harry878710/Automatic_Mobile_Boat_CapstoneTopics/工科專論_期末報告_第九組.pdf

## 工科專論<第九組>期末報告

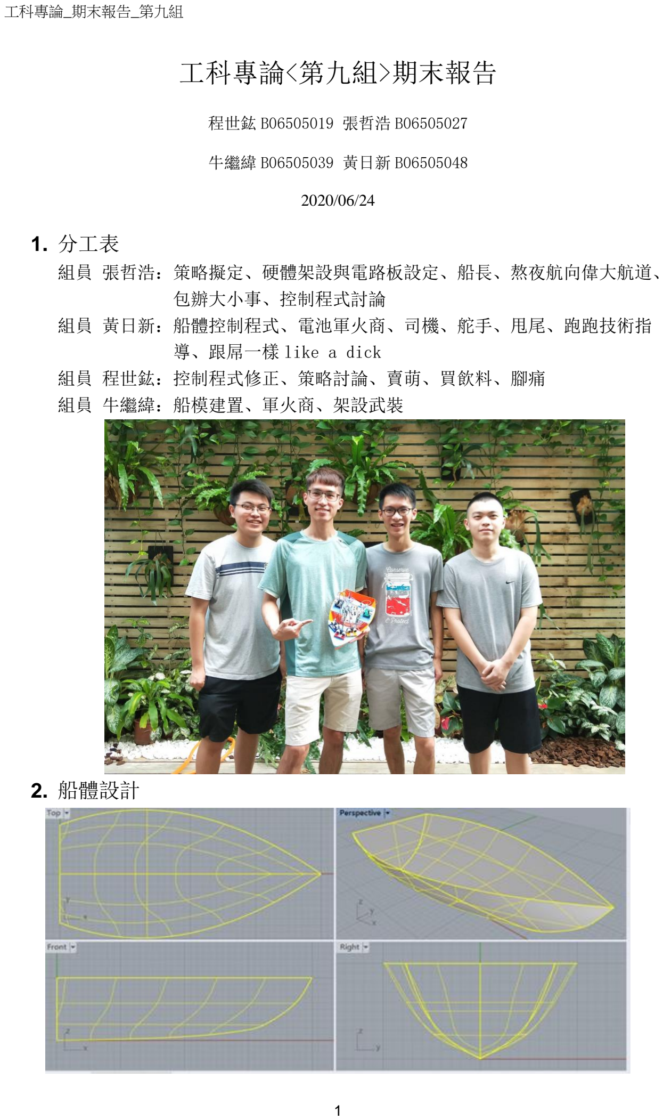
[picture p1: page 1]

工科專論_期末報告_第九組

程世鈜 B06505019 張哲浩 B06505027

牛繼緯 B06505039 黃日新 B06505048

2020/06/24

### 1. 分工表

組員 張哲浩：策略擬定、硬體架設與電路板設定、船長、熬夜航向偉大航道、 包辦大小事、控制程式討論
組員 黃日新：船體控制程式、電池軍火商、司機、舵手、甩尾、跑跑技術指 導、跟屌一樣 like a dick
組員 程世鈜：控制程式修正、策略討論、賣萌、買飲料、腳痛
組員 牛繼緯：船模建置、軍火商、架設武裝

### 2. 船體設計

考慮到長度限制、吃水、賽道寬度和旋轉半徑，將船長設為 40cm，船寬設為 20cm，船高 10cm，盡量在符合規定的範圍內取得吃水深度與旋轉半徑兩者間的平衡， 讓船不至於太長而造成轉彎不易或因為迴轉半徑過大而增加碰撞，也不會因為太短而 需要增加高度來達到目標的排水量；船寬則因為原本賽道迴轉區寬度為 30cm，略寬的 船體可以讓超音波感測器更快感測到牆壁而避免碰撞。
船體設計為了避免翻船或晃動過多導致進水，整體以穩度為優先考量，因此使

用倒三角形的船型來設計來增加 GM 值，最後的效果也不錯(1.42 cm)，同時倒三角形

也能有效地增加預備浮力；船底的部分收成直角，可以比圓弧型的船底增加更多吃水

面積，船的高度也能控制在一定範圍內，使重心不會偏高；船身的部分盡量把曲率拉

得連續，讓整體形狀更加流線以降低水的阻力；船尾選擇切齊而不做尖尾是為了能讓

船體在有限的長度內增加吃水面積，讓水線不要太高，同時也能增加船體的實際長

度，但在這裡因為速度較低所以影響應該不大。
螺槳裝在船的正後方以發揮最大動力，高度約在船底到水線的中間，使兩者不 會因為距離太近而互相影響，也足夠提供轉彎所需的較大力矩。馬達因為考慮到軸的 長度設置在船體的偏前方處，同時也因船體後方較深、前方較淺，因此將主電路板和 電池裝設在後方，使整體重心能與空船時保持一致。
4. 放入你船體的實際圖片

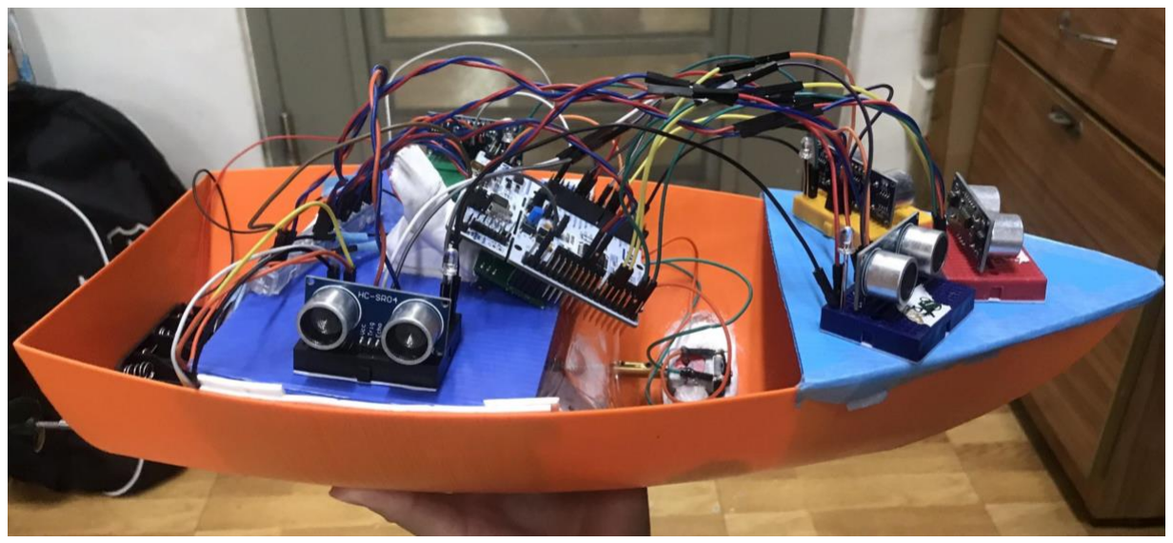
[picture p2: figure]

fg. 跟屌一樣號

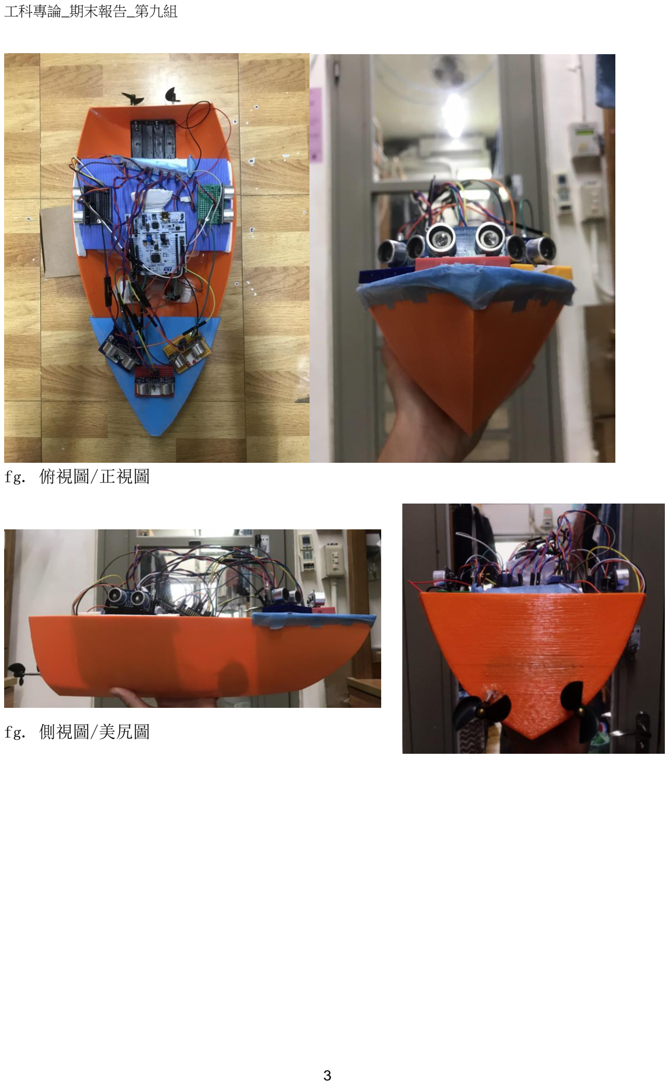
[picture p3: page 3]

fg. 俯視圖/正視圖

fg. 側視圖/美尻圖

### 3. 電路設計

控制硬體(stm32)設置：

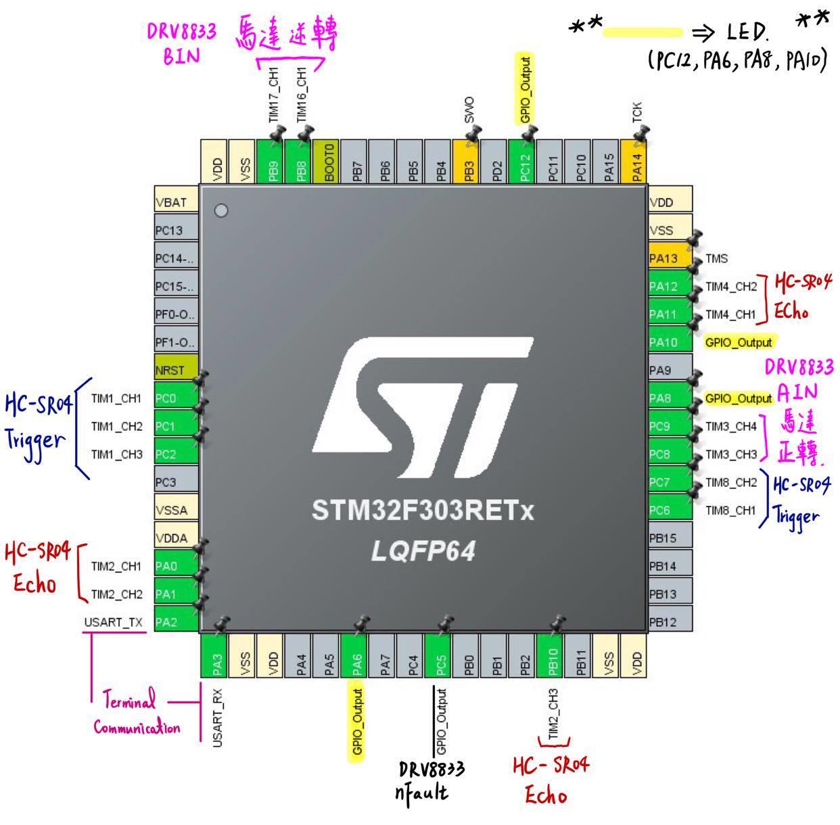
[picture p4: figure]

TIM/GPIO 的使用：

TIM 總共使用 7 個

TIM1 & TIM8 負責超音波 Trigger，TIM2 & TIM4 負責超音波 Echo，TIM3 & TIM16 & TIM17 負責控制馬達。

GPIO Output 總共使用 5 個

PC5 控制馬達晶片的開啟。
PA10/PA6/PA8/PC12 分別控制 左前/右前/左邊/右邊 的 LED 燈。

USART：
PA2/PA3 分別控制 USART_TX & USART_RX 與電腦終端機做溝通，確認超音波測距狀 況。

馬達驅動：

我們將馬達的正負極接到 4 個 Channel 分別設為 PWM Generation，將 counter period 設為 100，如此一來可以將轉速分級成百分比制，控制車輪的正逆轉。

分別開啟 TIM3_CH3 & TIM3_CH4 設為控制馬達正轉，TIM16_CH1 & TIM17_CH1 控 制逆轉。

超音波測距：

超聲波我們總共使用五組，設置三組測量前方（正前、左前 40 度、右前 40 度），兩組後方測量左右方與船身平行的牆面距離。

<Trigger>

TIM 配置：左前方 TIM1_CH1 / 前方 TIM1_CH2 / 右前方 TIM1_CH3 / 左後方 TIM8_CH1 / 右後方 TIM8_CH2。

超音波的 Trigger 我們統一將 TIM 的 channel 設為 PWM Generation，因為 TIM 的頻率是 8MHz，所以 Prescaler 我們設為 79，這樣一來一個 tick 所需的時間是 10us，counter period 設為 6999。透過以上設定，就可以透過 PWM 自動且規律地發出 有效訊號：每 70ms 中有 10us 高電位，進而發出訊號。

為了避免干擾，我們按照 左前、正前、右前、左後、右後 感測器的順序，依 序開啟 trigger 發波進行測距，測量完畢就關閉 PWM 換開啟下一個感測器的 PWM 發送 訊號測距。

<Echo>

TIM 配置：左前方 TIM2_CH1 / 前方 TIM2_CH2 / 右前方 TIM2_CH3 / 左後方 TIM4_CH1 / 右後方 TIM4_CH2。

超音波的 Echo 我們將 TIM 的 channel 設定為 input capture direct mode，將 counter period 設為最大，polarity selection 設為 Both Edges，如此一來便可以 抓到從高低電位間轉換的訊號。在 rising edge 將 counter 歸零，falling edge 記 數，記錄 echo 在高電位的總記數，將記數轉換為時間，再計算成距離。

TIM 頻率皆設為 8MHz，prescaler 設為 7，每 1us 記數一次，聲速每 29us 移動 1cm (1cm/(340m*10^2) = 29us)。所以超音波來回距離等於(總記數 cnt*10^-6)/(29*10^-6)，我們所要求的單一趟距離為：cnt/29/2。

控制演算法：

首先定義各個狀態（state），用來代表船不同的行進狀況，各狀態間的轉變條 件會在後面說明。

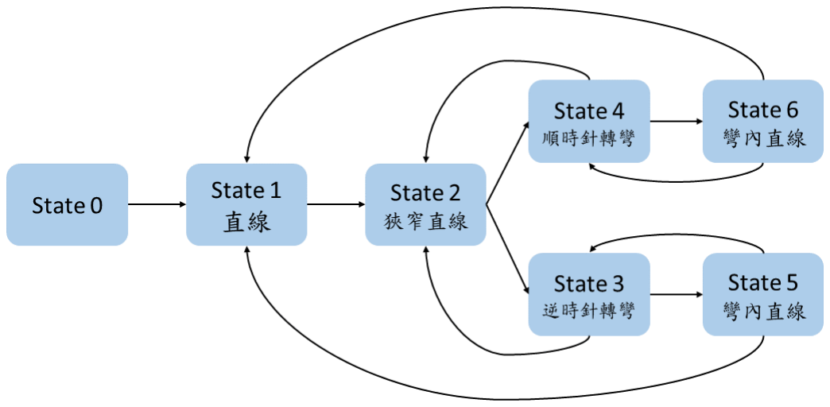
[picture p5: figure]

程式會記錄下感測器最近五次測得的距離，利用上述距離，以及目前的狀態， 判斷船所在位置、姿態和即將面臨的障礙物，透過切換狀態或改變馬達轉速，做出相 對應的動作，以閃避障礙物並通過賽道。不論在任何狀態下，程式都會先判斷船的前 方是否離障礙物太近，若是則會控制馬達逆轉使船後退。

各狀態判斷演算法：

state 0：此為初始狀態，船預設會快速前進。

- 若船有向前移動（前方測距連續兩次降低），即會進入 state 1。

state 1：船預設會中速前進。

- 若偵測到船進入狹窄區（左後方及右後方測距皆小於 30 cm），即會進入 state 2。

state 2：船預設會中速前進。

- 若船有向左右偏移（利用左後方或右後方測距的差值，以及其測距之變化）， 程式會控制馬達轉速修正方向，使船回到賽道中央。
- 若偵測到前方有障礙物（前方測距小 80 cm 且連續下降小於 10 cm 三次），程 式會根據後方超音波測距，判斷船的左右位置，決定要進入 state 3 或 state 4。

state 3：程式會根據前方三個感測器的測距大小，並透過左後方感測器的測距輔助，

定出船身位於彎內的姿態與位置。

- 若判斷船在彎道內側（前方及右前方測距皆過小），則會控制馬達進行左轉。
- 若判斷船在彎道外側（前方測距尚有空間），包含剛從直線區進入或是已經可 以從迴轉區離開，則會控制馬達進行右轉。
- 若前方尚有空間（前方測距或左前方測距大於 70 cm），則會進入 state 5。
- 若前方淨空（前方測距連續三次大於 100 cm），則會回到 state 2。

state 4：此狀態與 state 3 相似，僅將左右側距和左右轉相反。

- 若判斷船在彎道內側（前方及右前方測距皆過小），則會控制馬達進行右轉。
- 若判斷船在彎道外側（前方測距尚有空間），包含剛從直線區進入或是已經可 以從迴轉區離開，則會控制馬達進行左轉。
- 若前方尚有空間（前方測距或右前方測距大於 70 cm），則會進入 state 6。
- 若前方淨空（前方測距連續三次大於 100 cm），則會回到 state 2。

state 5：船預設會慢速前進。

- 若船有向左右偏移（利用右後方測距之變化），程式會控制馬達轉速修正方 向。

- 若偵測到前方有障礙物（前方測距小於 45 cm），則會回到 state 3 繼續左 轉。
- 若前方淨空（前方測距連續三次大於 100 cm），則會回到 state 1。

state 6：此狀態與 state 5 相似，僅將左右側距和左右轉相反。

- 若船有向左右偏移（利用左後方測距之變化），程式會控制馬達轉速修正方 向。
- 若偵測到前方有障礙物（前方測距小於 45 cm），則會回到 state 4 繼續右 轉。
- 若前方淨空（前方測距連續三次大於 100 cm），則會回到 state 1。

各狀態代碼與燈號表：

※燈號代碼：暗燈(0)、慢閃(1)、快閃(2)、亮燈(3)。燈號順序為「左前、右前、左 側、右側」

※燈號表詳見 <4.額外設計>

## 控制程式碼

//全域變數

//「dis_F、dis_rF、dis_lF、dis_rR、dis_lR」分別代表「前方、右前方、左前方、右

後方、左後方」超聲波目前的測距

//「F、rF、lF、rR、lR」代表過去五次的測距

//「LED_rF、LED_lF、LED_right、LED_left」分別代表「右前方、左前方、右側、左

側」LED 的燈號代碼

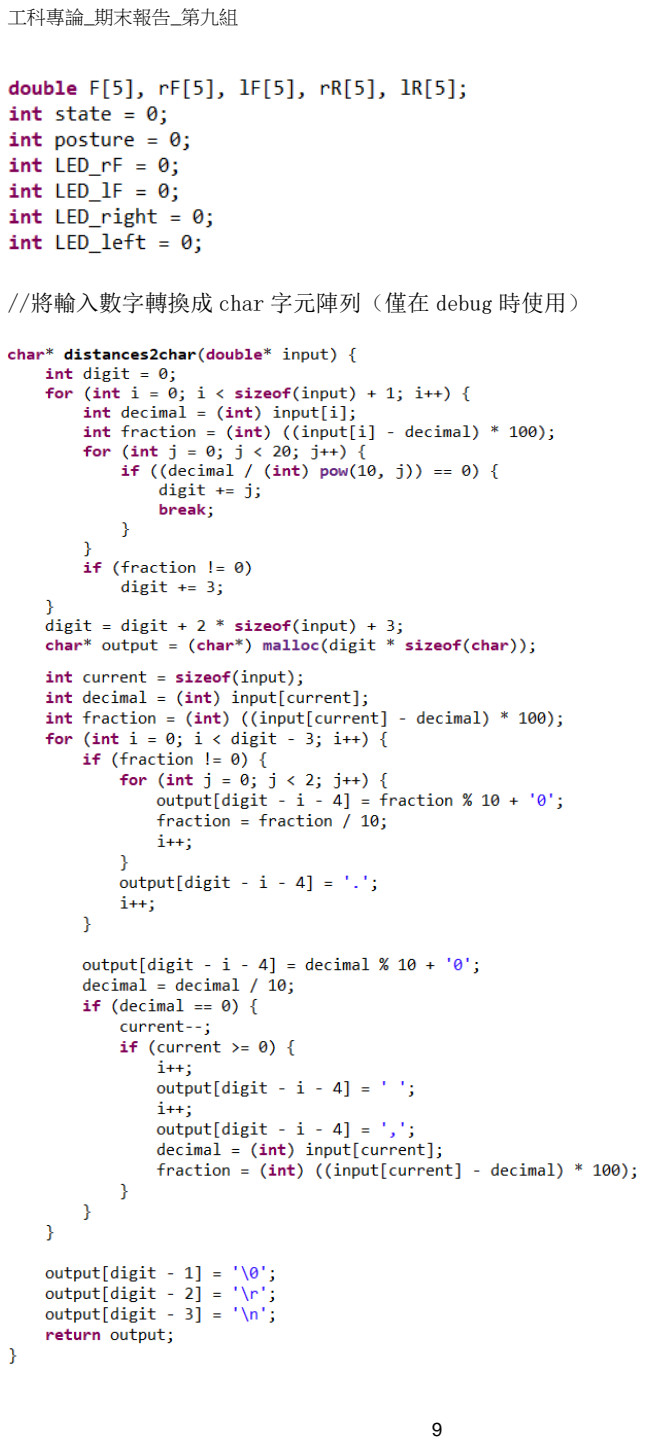
[picture p6: page 9]

//將輸入數字轉換成 char 字元陣列（僅在 debug 時使用）

//將資料回傳至 terminal 並 print 出（僅在 debug 時使用）

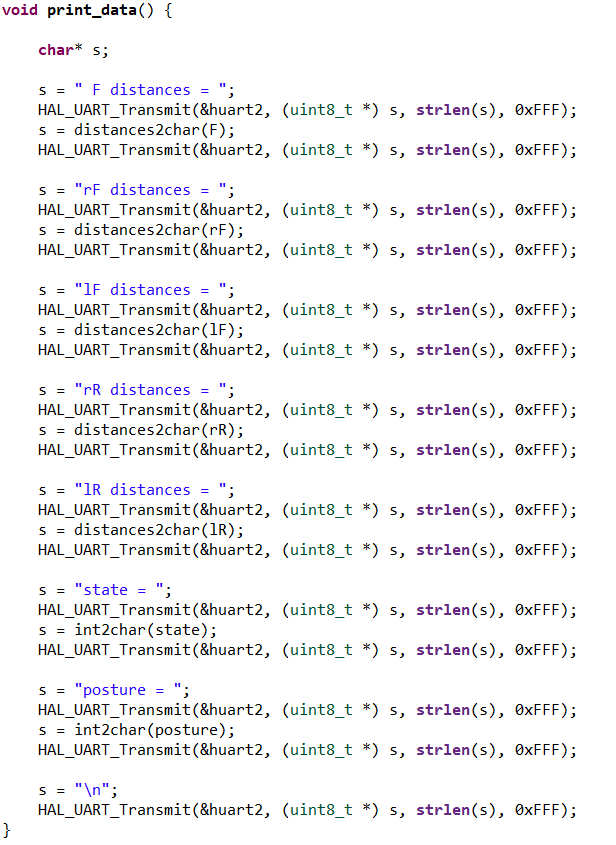
[picture p7: figure]

//超音波的 Echo 測距分別回傳至全域變數 dis_lF, dis_F, dis_rF, dis_lR, dis_rR

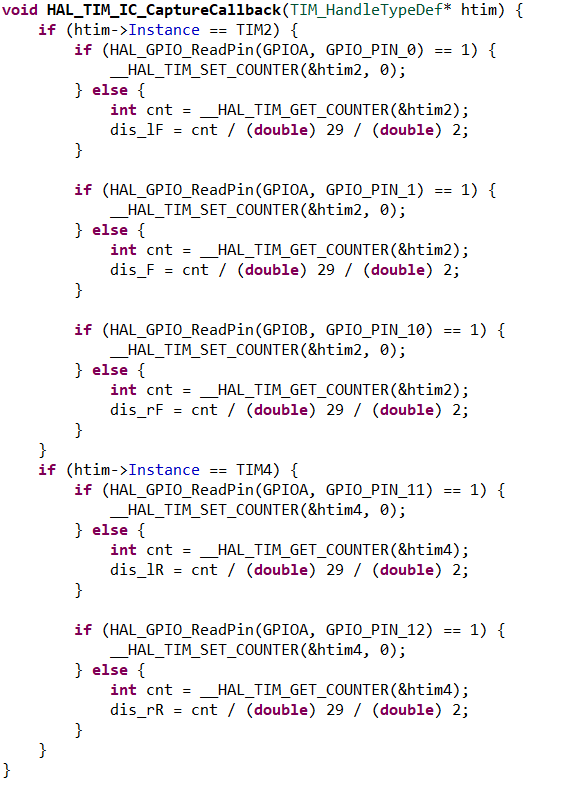
[picture p8: figure]

//進階控制函式，針對不同賽道環境做變化，判斷船的位置與姿態

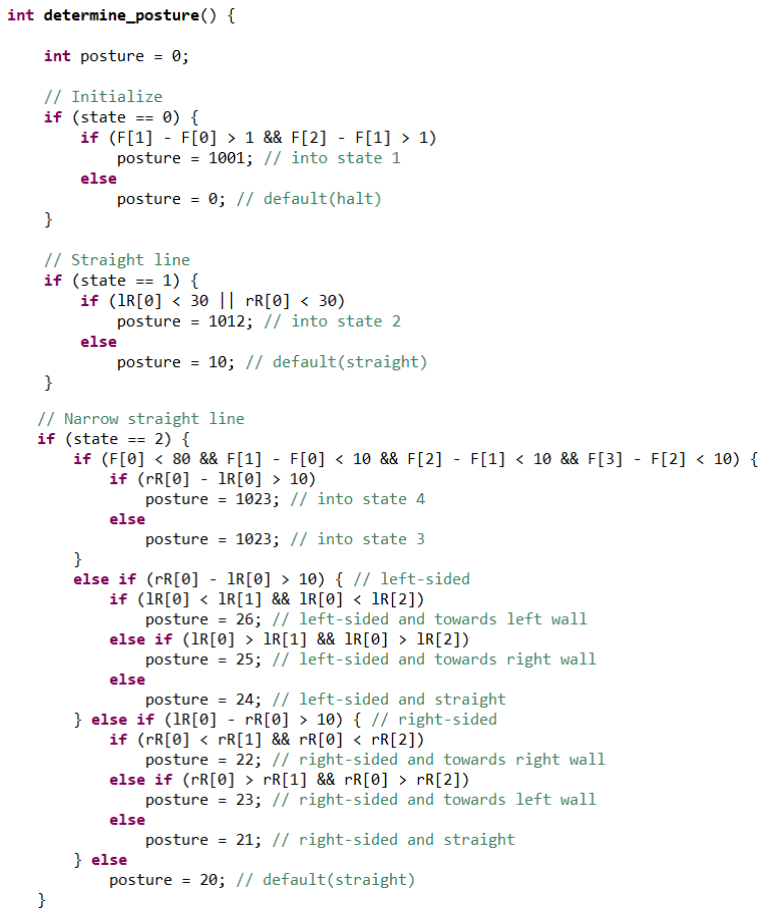
[picture p9: figure]

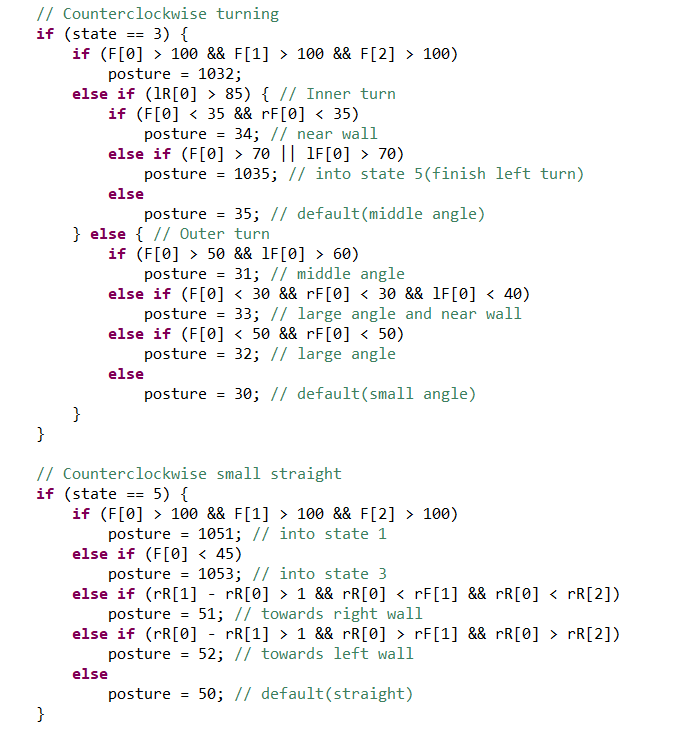
[picture p10: figure]

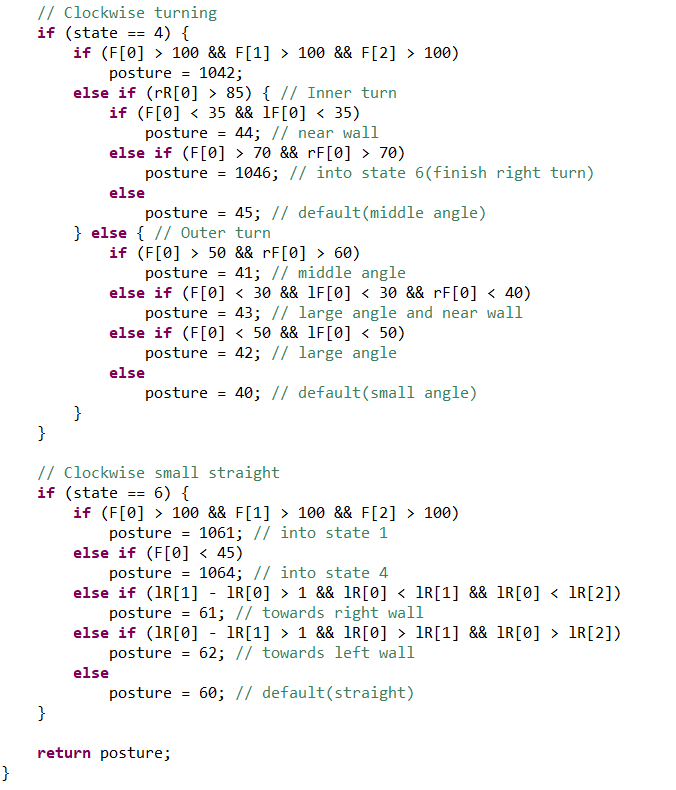
[picture p11: figure]

//由狀態決定馬達的轉速以及 LED 燈的燈號

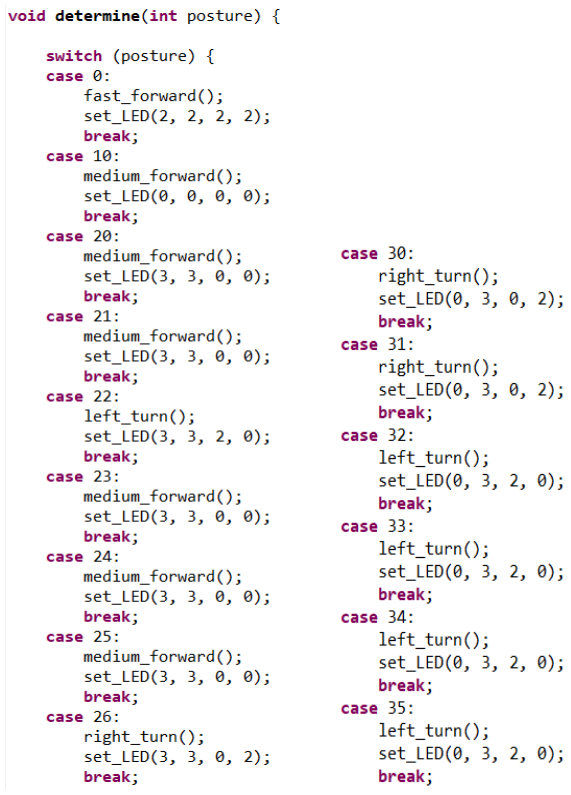
[picture p12: figure]

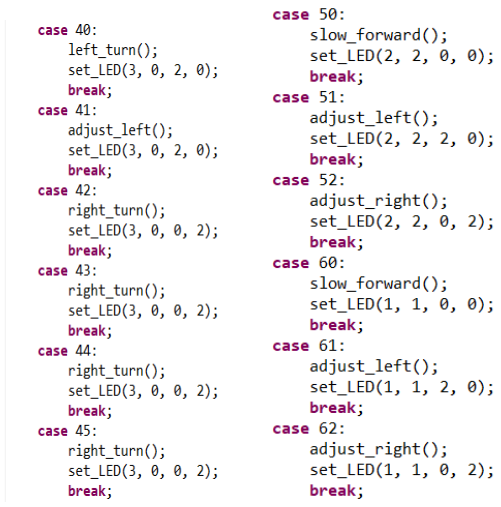
[picture p13: figure]

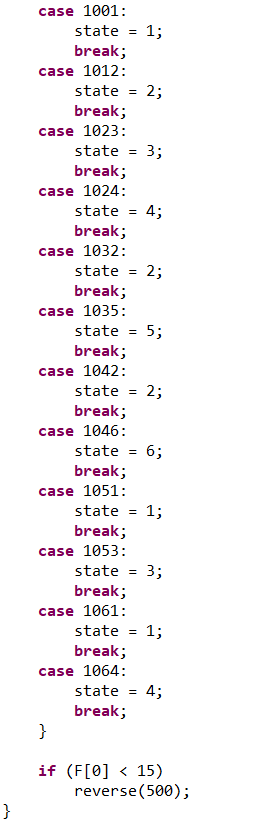
[picture p14: figure]

//各種馬達轉換函式

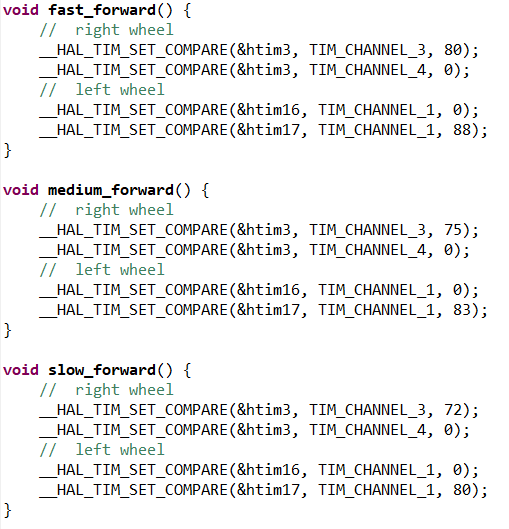
[picture p15: figure]

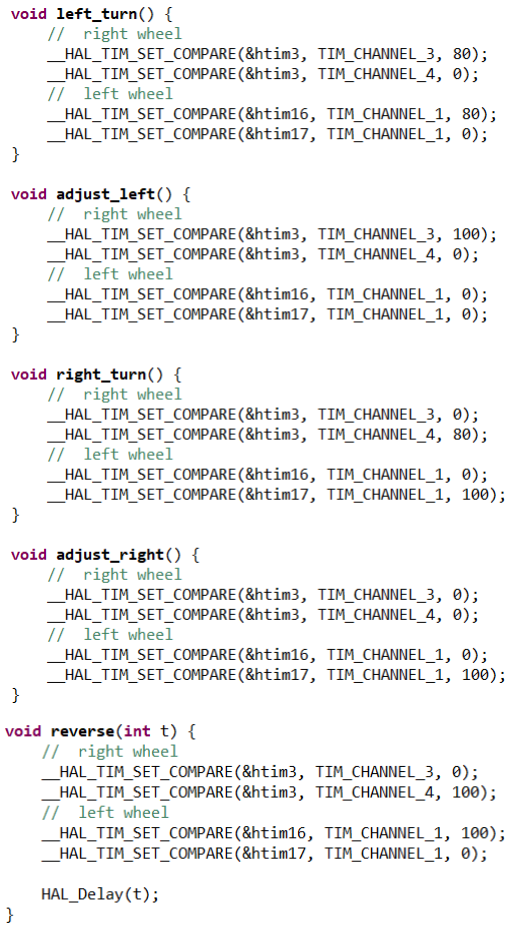
[picture p16: figure]

//LED 燈控制函式

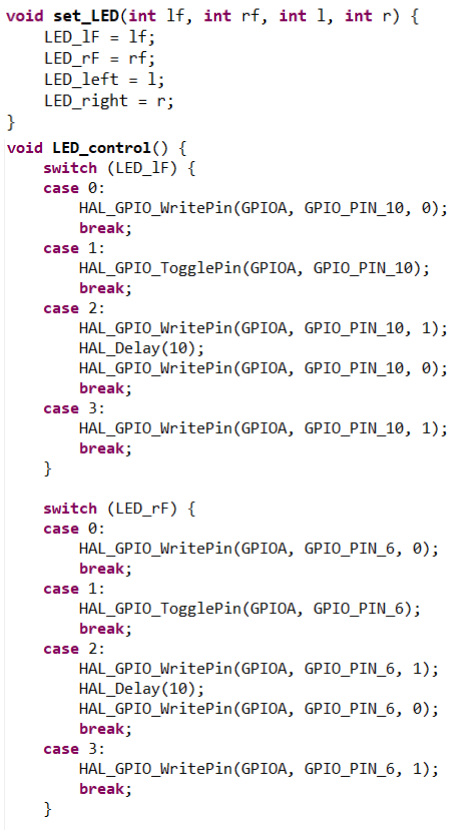
[picture p17: figure]

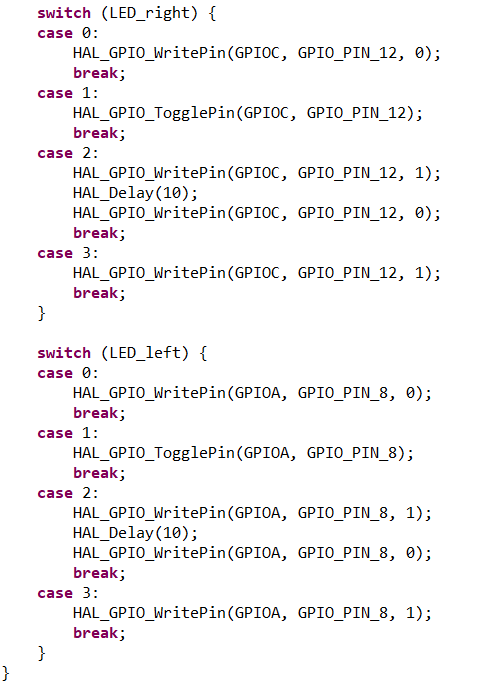
[picture p18: figure]

//以下為 main 函式內的程式碼

//初始化

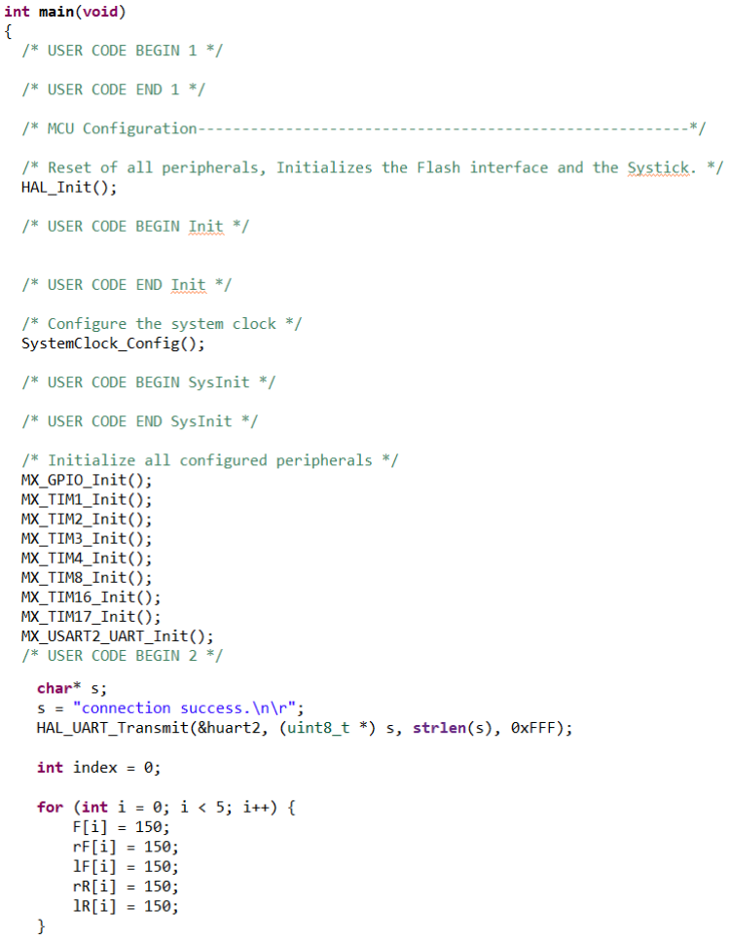
[picture p19: figure]

//開啟馬達 PWM，以及開啟 Echo 腳位 Timer 的 input capture

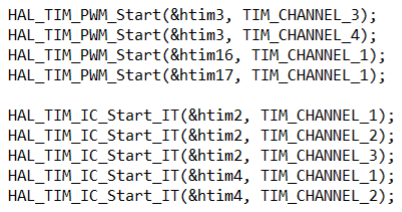
[picture p20: figure]

//程式會記錄下感測器最近五次測得的距離，更新的距離會遞補上去

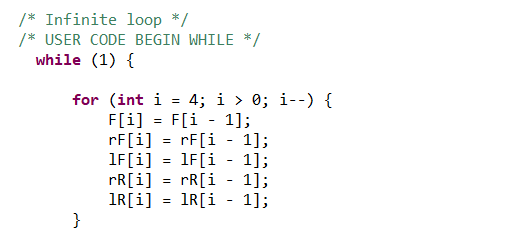
[picture p21: figure]

//超音波 trigger 的 PWM 分別開啟關閉

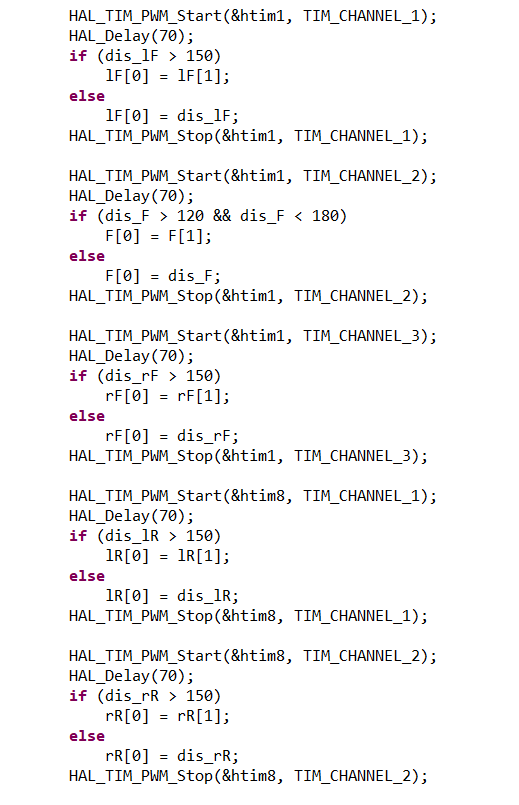
[picture p22: figure]

//執行判斷函式

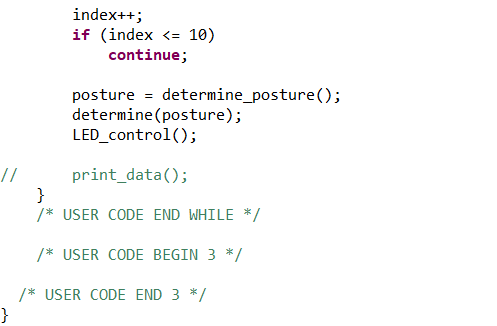
[picture p23: figure]

### 4. 額外設計

由於我們的控制設計使用狀態切換會有不同的控制效果，所以需要確認 船處在哪個狀態，故配置狀態燈以做分析判斷。

前後方左右處各兩顆 LED 燈，總共 4 顆燈製作信號。 燈的狀態有四種：暗燈(0)、慢閃(1)、快閃(2)、亮燈(3)。藉此開發出 以下燈號表（共 2 頁），並確保每位船員熟稔此份燈號表。

電路配置：
設置控制燈泡的腳位為 GPIO Output，分別將 PA10/PA6/PA8/PC12 的腳 位控制左前/右前/左邊/右邊的 LED 燈。

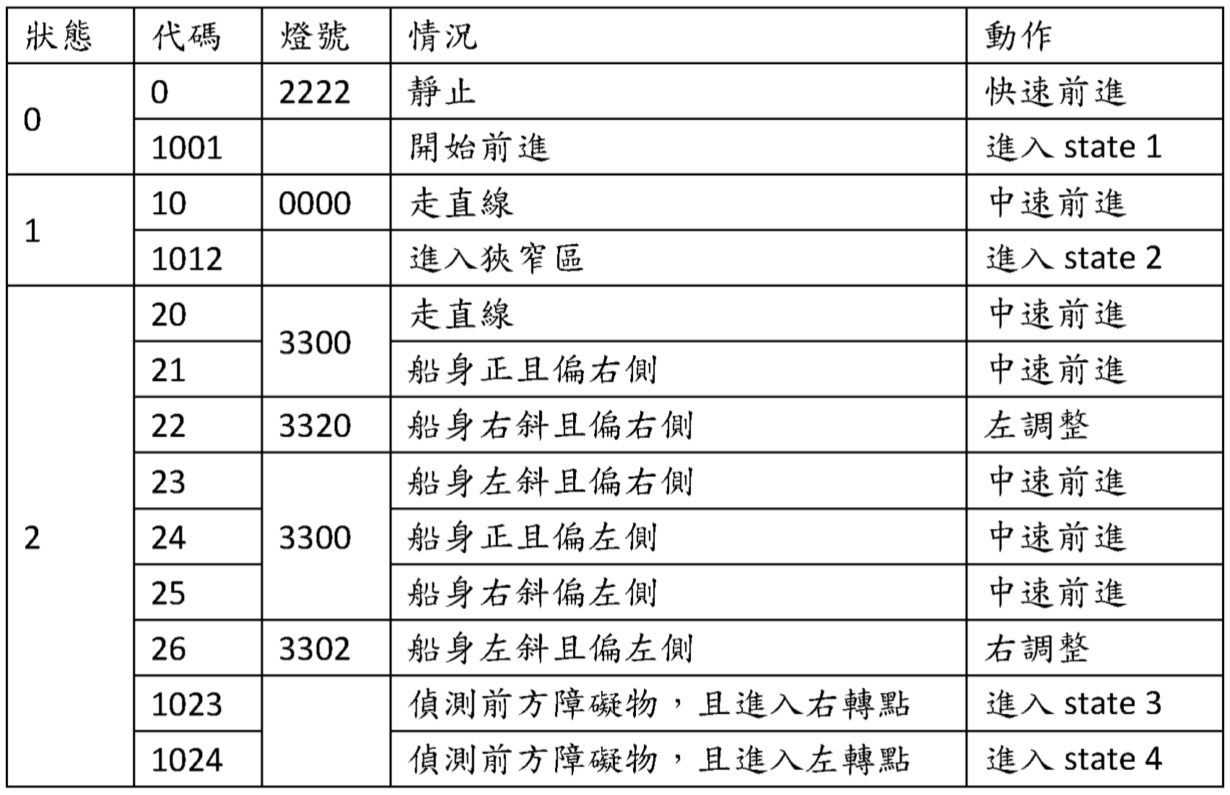
[picture p24: figure]

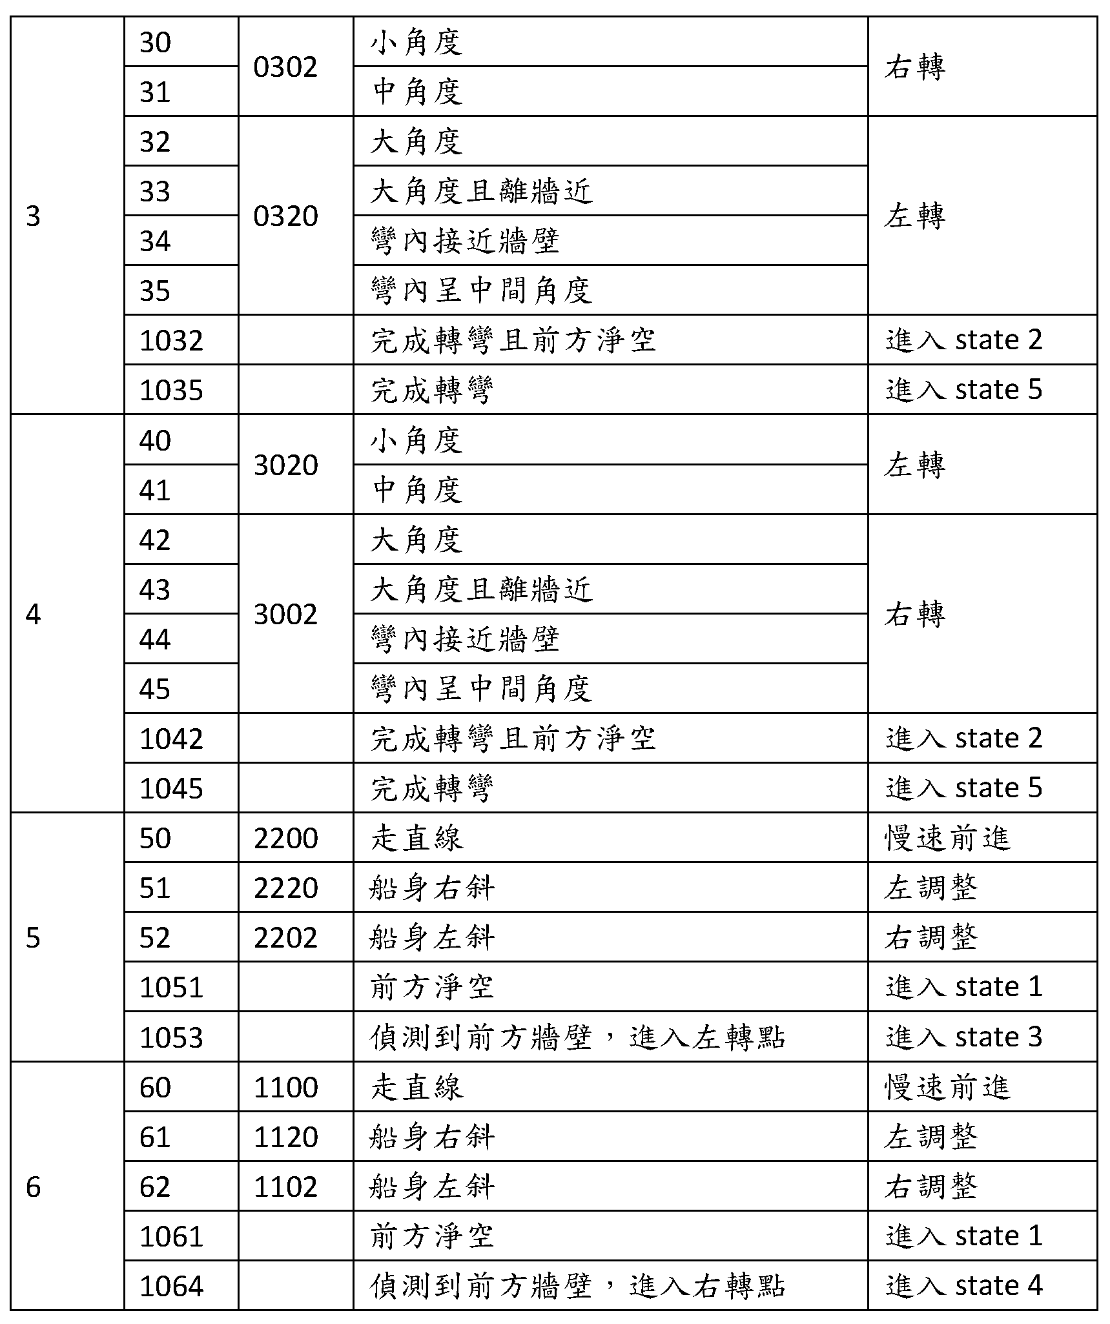
[picture p25: figure]

---THE END---
