harry878710/Automatic_Mobile_Boat_CapstoneTopics/AutoBoat_0622/AutoBoat_0606.ioc

Mcu.UserName=STM32F303RETx
PA0.Signal=S_TIM2_CH1_ETR
PA1.Signal=S_TIM2_CH2
PA10.Signal=GPIO_Output
PA11.Signal=S_TIM4_CH1
PA12.Signal=S_TIM4_CH2
PA13.GPIO_Label=TMS
PA13.Signal=SYS_JTMS-SWDIO
PA14.GPIO_Label=TCK
PA14.Signal=SYS_JTCK-SWCLK
PA2.GPIO_Label=USART_TX
PA2.Signal=USART2_TX
PA3.GPIO_Label=USART_RX
PA3.Signal=USART2_RX
PA6.Signal=GPIO_Output
PA8.Signal=GPIO_Output
PB10.Signal=S_TIM2_CH3
PB3.GPIO_Label=SWO
PB3.Signal=SYS_JTDO-TRACESWO
PB8.Signal=S_TIM16_CH1
PB9.Signal=S_TIM17_CH1
PC0.Signal=S_TIM1_CH1
PC1.Signal=S_TIM1_CH2
PC12.Signal=GPIO_Output
PC2.Signal=S_TIM1_CH3
PC4.Signal=GPIO_Output
PC5.Signal=GPIO_Output
PC6.Signal=S_TIM8_CH1
PC7.Signal=S_TIM8_CH2
PC8.Signal=S_TIM3_CH3
PC9.Signal=S_TIM3_CH4
